cactorium/sweep-radar-proto-2.4GHz/digital/digital.kicad_pcb

## KiCad design digital/digital.kicad_pcb (2018-04-24)

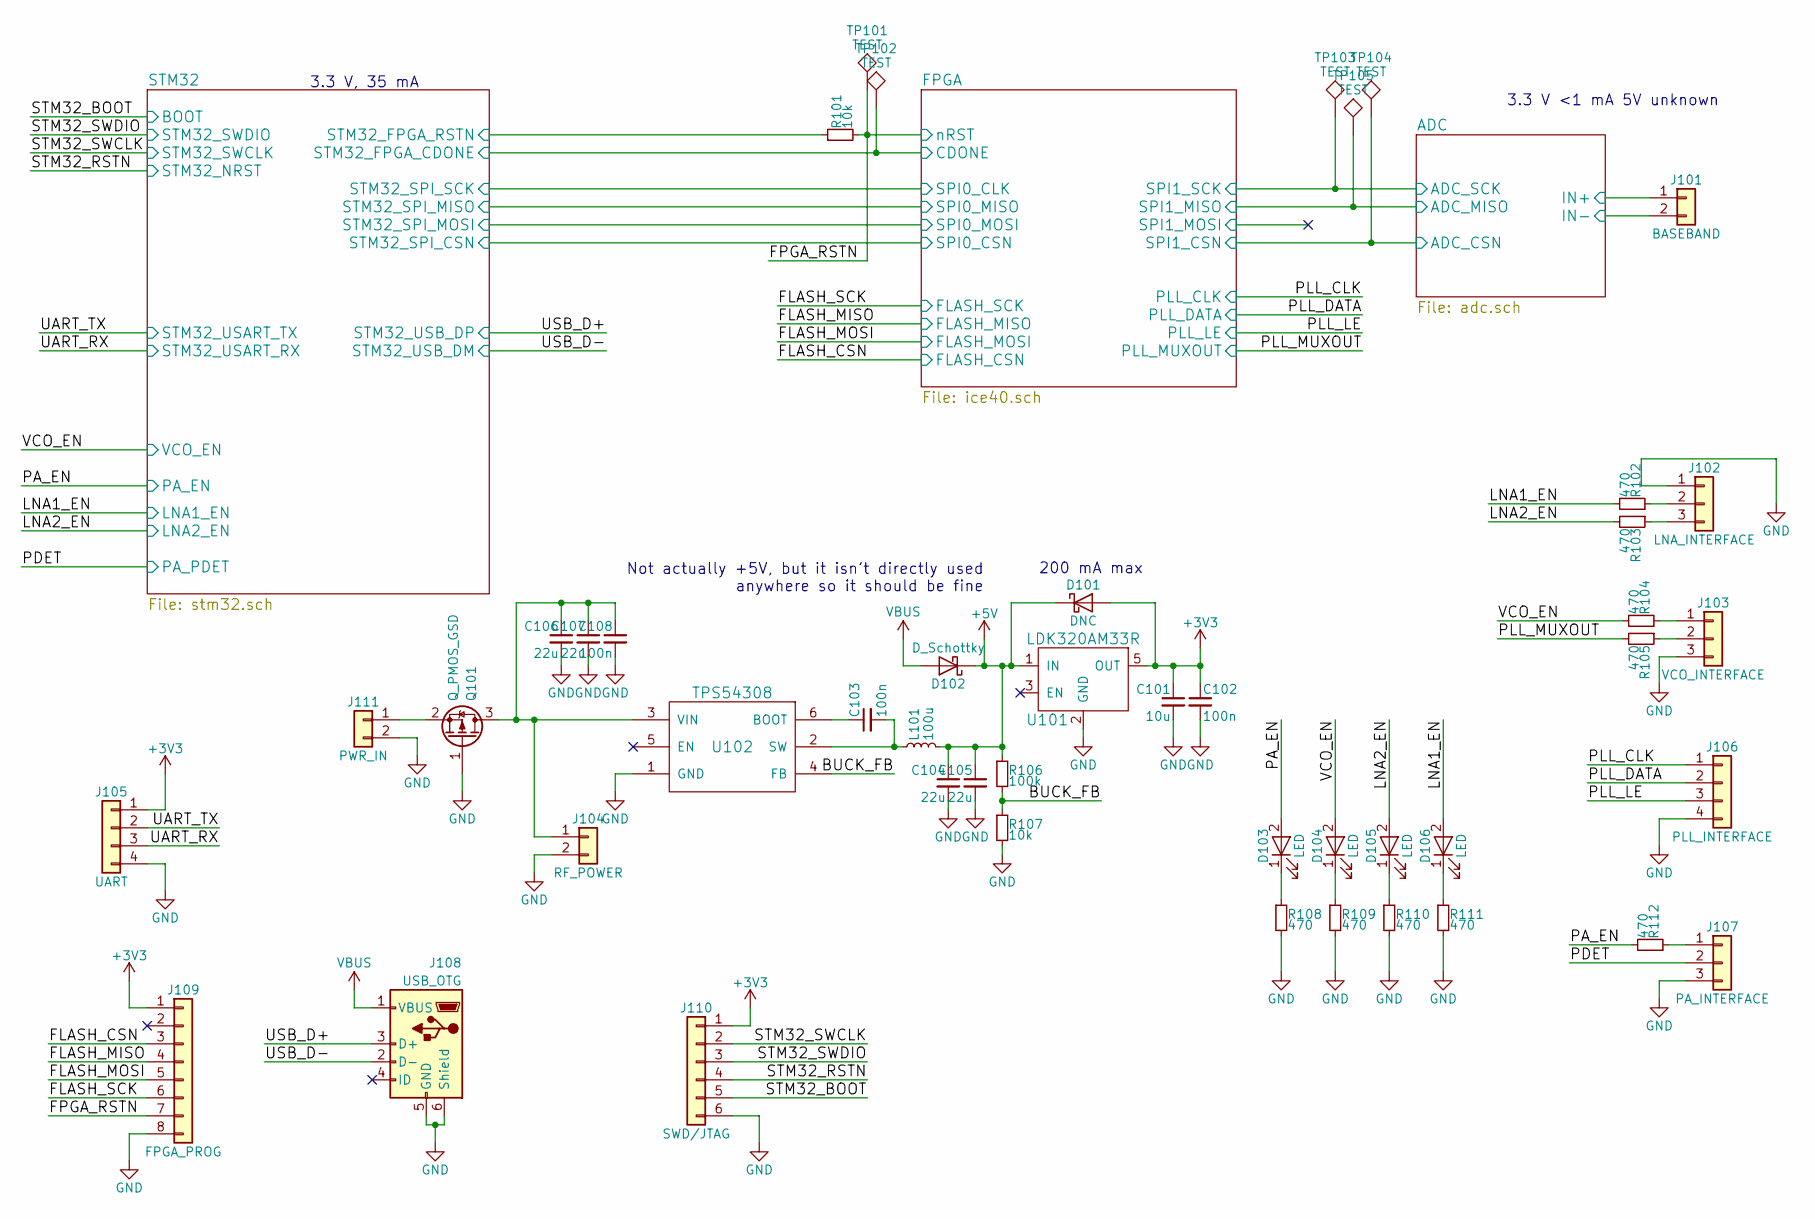
[picture p1: schematic digital.sch]

Parts:
C101: 10u; C_0805_HandSoldering
C102, C103, C108: 100n; C_0603_HandSoldering
C104, C105, C106, C107: 22u; C_1210_HandSoldering
D101: DNC; Panasonic_Diode-1006
D102: D_Schottky; Panasonic_Diode-1006
D103, D104, D105, D106: LED; D_0603
J101: BASEBAND; Pin_Header_Straight_1x02_Pitch2.54mm
J102: LNA_INTERFACE; Pin_Header_Straight_1x03_Pitch2.54mm
J103: VCO_INTERFACE; Pin_Header_Straight_1x03_Pitch2.54mm
J104: RF_POWER; Pin_Header_Straight_1x02_Pitch2.54mm
J105: UART; Pin_Header_Straight_2x02_Pitch2.54mm
J106: PLL_INTERFACE; Pin_Header_Straight_1x04_Pitch2.54mm
J107: PA_INTERFACE; Pin_Header_Straight_1x03_Pitch2.54mm
J108: USB_OTG; 10118194
J109: FPGA_PROG; Pin_Header_Straight_2x04_Pitch2.54mm
J110: SWD/JTAG; Pin_Header_Straight_2x03_Pitch2.54mm
J111: PWR_IN; Pin_Header_Straight_1x02_Pitch2.54mm
L101: 100u; Murata_DG6050C
Q101: Q_PMOS_GSD; SOT-23
R101, R107: 10k; R_0603_HandSoldering
R102, R103, R104, R105, R108, R109, R110, R111, R112: 470; R_0603_HandSoldering
R106: 100k; R_0402
TP101, TP102, TP103, TP104, TP105: TEST; Measurement_Point_Round-SMD-Pad_Small
U101: LDK320AM33R; ST_SOT23-5L
U102: TPS54308; TI-SOT-23-6

Connections:
+5V: C104.1, C105.1, D101.1 (K), D102.1 (K), L101.2, R106.1, U101.1 (IN); also elsewhere on the board
/ADC/ADC_CSN: TP104.1; also elsewhere on the board
/ADC/ADC_MISO: TP105.1; also elsewhere on the board
/ADC/ADC_SCK: TP103.1; also elsewhere on the board
/ADC/IN+: J101.1; also elsewhere on the board
/ADC/IN-: J101.2; also elsewhere on the board
/BUCK_FB: R106.2, R107.1, U102.4 (FB)
/FLASH_CSN: J109.3; also elsewhere on the board
/FLASH_MISO: J109.4; also elsewhere on the board
/FLASH_MOSI: J109.5; also elsewhere on the board
/FLASH_SCK: J109.6; also elsewhere on the board
/FPGA/CDONE: TP102.1; also elsewhere on the board
/FPGA_RSTN: J109.7, R101.2, TP101.1; also elsewhere on the board
/LNA1_EN: D106.2 (A), R102.2; also elsewhere on the board
/LNA2_EN: D105.2 (A), R103.2; also elsewhere on the board
/PA_EN: D103.2 (A), R112.2; also elsewhere on the board
/PDET: J107.2; also elsewhere on the board
/PLL_CLK: J106.1; also elsewhere on the board
/PLL_DATA: J106.2; also elsewhere on the board
/PLL_LE: J106.3; also elsewhere on the board
/PLL_MUXOUT: R105.2; also elsewhere on the board
/STM32/STM32_FPGA_RSTN: R101.1; also elsewhere on the board
/STM32_BOOT: J110.5; also elsewhere on the board
/STM32_RSTN: J110.4; also elsewhere on the board
/STM32_SWCLK: J110.2; also elsewhere on the board
/STM32_SWDIO: J110.3; also elsewhere on the board
/UART_RX: J105.3; also elsewhere on the board
/UART_TX: J105.2; also elsewhere on the board
/USB_D+: J108.3 (D+); also elsewhere on the board
/USB_D-: J108.2 (D-); also elsewhere on the board
/VCO_EN: D104.2 (A), R104.2; also elsewhere on the board
unnamed: C103.1, U102.6 (BOOT)
unnamed: C103.2, L101.1, U102.2 (SW)
unnamed: C106.1, C107.1, C108.1, J104.1, Q101.3 (D), U102.3 (VIN)
unnamed: D103.1 (K), R108.1
unnamed: D104.1 (K), R109.1
unnamed: D105.1 (K), R110.1
unnamed: D106.1 (K), R111.1
unnamed: J102.2, R102.1
unnamed: J102.3, R103.1
unnamed: J103.1, R104.1
unnamed: J103.2, R105.1
unnamed: J107.1, R112.1
unnamed: J111.1, Q101.2 (S)
VBUS: D102.2 (A), J108.1 (VBUS)

Notes on the sheet:
Not actually +5V, but it isn't directly used anywhere so it should be fine
200 mA max
3.3 V <1 mA 5V unknown
3.3 V, 35 mA

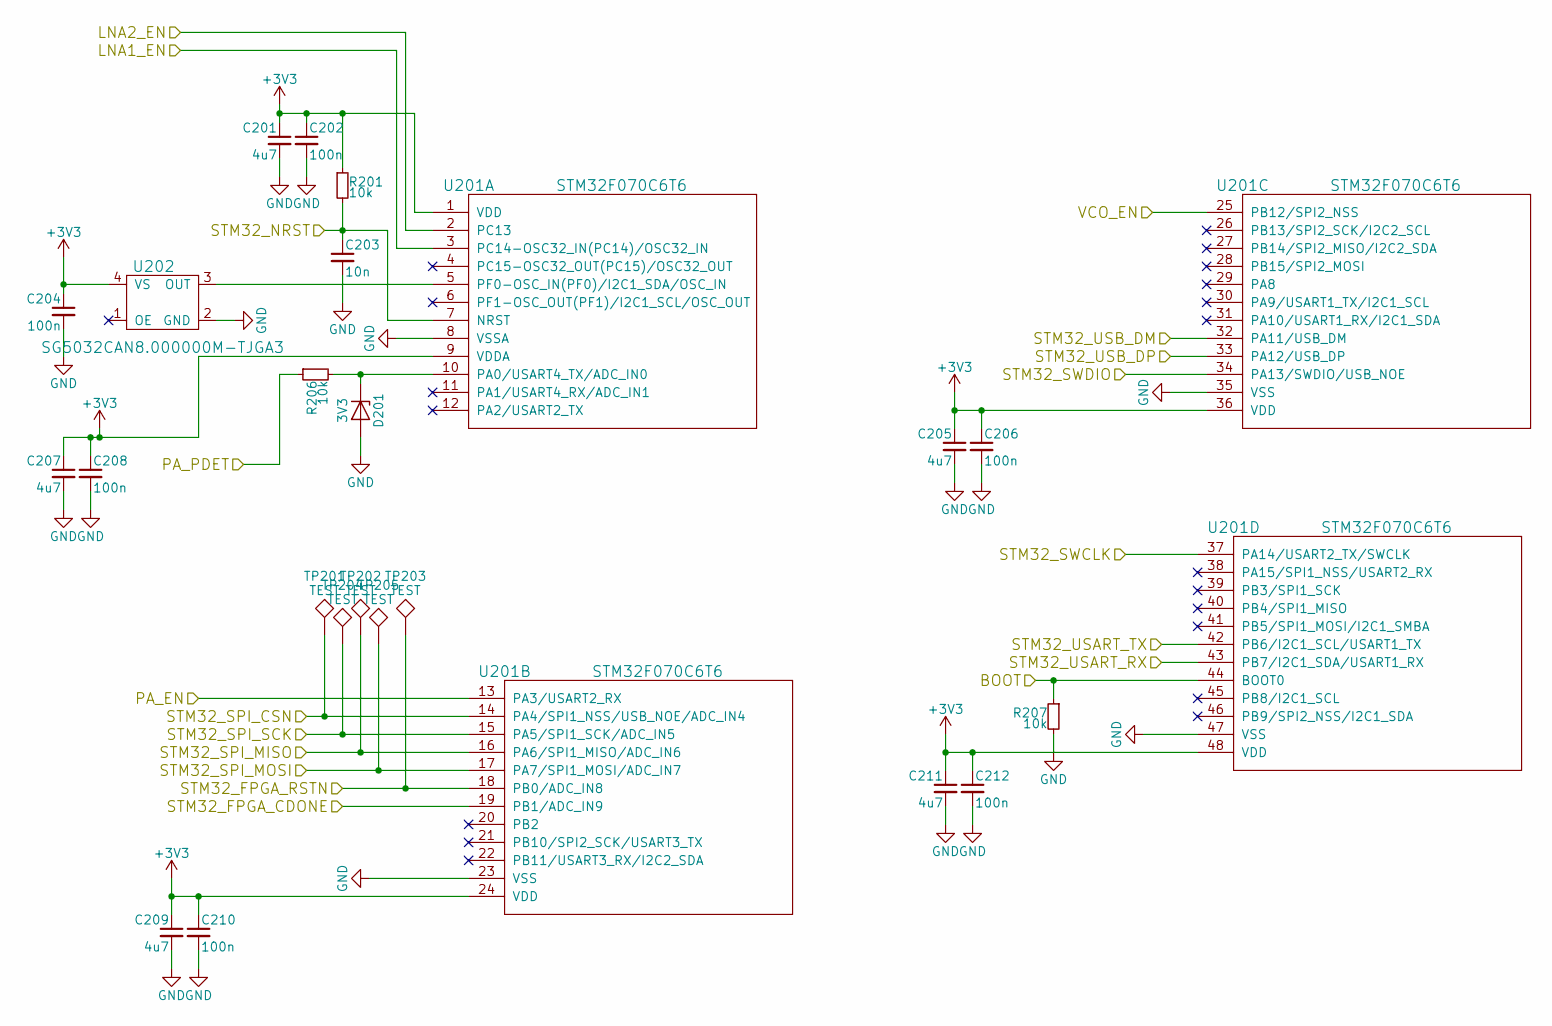
[picture p2: schematic stm32.sch]

Parts:
C201, C205, C207, C209, C211: 4u7; C_1206_HandSoldering
C202, C204, C206, C208, C210, C212: 100n; C_0603_HandSoldering
C203: 10n; C_0402
D201: 3V3; Diodes_SOD923
R201, R206, R207: 10k; R_0603_HandSoldering
TP201, TP202, TP203, TP204, TP205: TEST; Measurement_Point_Round-SMD-Pad_Small
U201: STM32F070C6T6; ST_LQFP48
U202: SG5032CAN8.000000M-TJGA3; Oscillator_SMD_SeikoEpson_SG8002LB-4pin_5.0x3.2mm_HandSolde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

Connections:
/FPGA/CDONE: U201.19 (PB1/ADC_IN9); also elsewhere on the board
/FPGA/SPI0_CLK: TP204.1, U201.15 (PA5/SPI1_SCK/ADC_IN5); also elsewhere on the board
/FPGA/SPI0_CSN: TP201.1, U201.14 (PA4/SPI1_NSS/USB_NOE/ADC_IN4); also elsewhere on the board
/FPGA/SPI0_MISO: TP202.1, U201.16 (PA6/SPI1_MISO/ADC_IN6); also elsewhere on the board
/FPGA/SPI0_MOSI: TP205.1, U201.17 (PA7/SPI1_MOSI/ADC_IN7); also elsewhere on the board
/LNA1_EN: U201.3 (PC14-OSC32_IN(PC14)/OSC32_IN); also elsewhere on the board
/LNA2_EN: U201.2 (PC13); also elsewhere on the board
/PA_EN: U201.13 (PA3/USART2_RX); also elsewhere on the board
/PDET: R206.1; also elsewhere on the board
/STM32/STM32_FPGA_RSTN: TP203.1, U201.18 (PB0/ADC_IN8); also elsewhere on the board
/STM32_BOOT: R207.1, U201.44 (BOOT0); also elsewhere on the board
/STM32_RSTN: C203.1, R201.2, U201.7 (NRST); also elsewhere on the board
/STM32_SWCLK: U201.37 (PA14/USART2_TX/SWCLK); also elsewhere on the board
/STM32_SWDIO: U201.34 (PA13/SWDIO/USB_NOE); also elsewhere on the board
/UART_RX: U201.43 (PB7/I2C1_SDA/USART1_RX); also elsewhere on the board
/UART_TX: U201.42 (PB6/I2C1_SCL/USART1_TX); also elsewhere on the board
/USB_D+: U201.33 (PA12/USB_DP); also elsewhere on the board
/USB_D-: U201.32 (PA11/USB_DM); also elsewhere on the board
/VCO_EN: U201.25 (PB12/SPI2_NSS); also elsewhere on the board
unnamed: D201.1 (K), R206.2, U201.10 (PA0/USART4_TX/ADC_IN0)
unnamed: U201.5 (PF0-OSC_IN(PF0)/I2C1_SDA/OSC_IN), U202.3 (OUT)

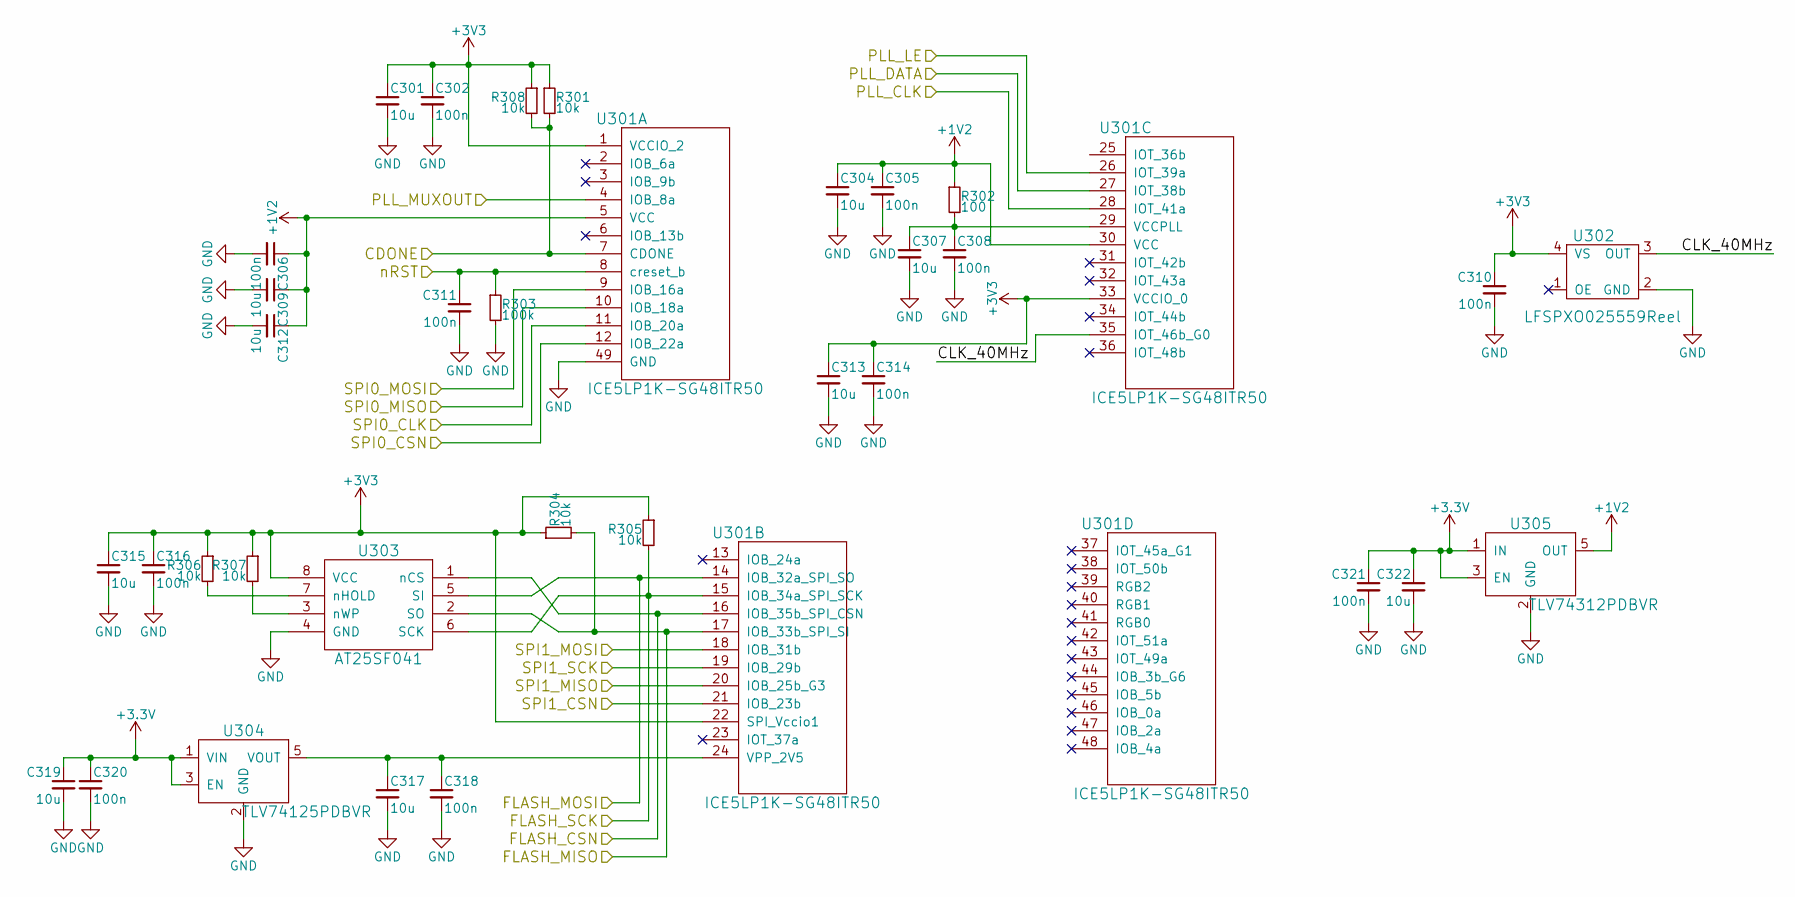
[picture p3: schematic ice40.sch]

Parts:
C301, C304, C307, C309, C312, C313, C315, C317, C319, C322: 10u; C_0805_HandSoldering
C302, C305, C306, C308, C310, C311, C314, C316, C318, C320, C321: 100n; C_0603_HandSoldering
R301, R304, R305, R306, R307, R308: 10k; R_0603_HandSoldering
R302: 100; R_0603_HandSoldering
R303: 100k; R_0402
U301: ICE5LP1K-SG48ITR50; Lattice_QFN48
U302: LFSPXO025559Reel; Crystal_SMD_3225-4pin_3.2x2.5mm_HandSoldering
U303: AT25SF041; SOIC-8_3.9x4.9mm_Pitch1.27mm
U304: TLV74125PDBVR; SOT-23-5_HandSoldering
U305: TLV74312PDBVR; SOT-23-5_HandSoldering

Connections:
+1V2: C304.1, C305.1, C306.1, C309.1, C312.1, R302.1, U301.5 (VCC), U301.30 (VCC), U305.5 (OUT)
/ADC/ADC_CSN: U301.21 (IOB_23b); also elsewhere on the board
/ADC/ADC_MISO: U301.20 (IOB_25b_G3); also elsewhere on the board
/ADC/ADC_SCK: U301.19 (IOB_29b); also elsewhere on the board
/FLASH_CSN: U301.16 (IOB_35b_SPI_CSN), U303.1 (nCS); also elsewhere on the board
/FLASH_MISO: R304.2, U301.17 (IOB_33b_SPI_SI), U303.2 (SO); also elsewhere on the board
/FLASH_MOSI: U301.14 (IOB_32a_SPI_SO), U303.5 (SI); also elsewhere on the board
/FLASH_SCK: R305.2, U301.15 (IOB_34a_SPI_SCK), U303.6 (SCK); also elsewhere on the board
/FPGA/CDONE: R301.2, R308.2, U301.7 (CDONE); also elsewhere on the board
/FPGA/CLK_40MHz: U301.35 (IOT_46b_G0), U302.3 (OUT)
/FPGA/SPI0_CLK: U301.11 (IOB_20a); also elsewhere on the board
/FPGA/SPI0_CSN: U301.12 (IOB_22a); also elsewhere on the board
/FPGA/SPI0_MISO: U301.10 (IOB_18a); also elsewhere on the board
/FPGA/SPI0_MOSI: U301.9 (IOB_16a); also elsewhere on the board
/FPGA_RSTN: C311.1, R303.1, U301.8 (creset_b); also elsewhere on the board
/PLL_CLK: U301.28 (IOT_41a); also elsewhere on the board
/PLL_DATA: U301.27 (IOT_38b); also elsewhere on the board
/PLL_LE: U301.26 (IOT_39a); also elsewhere on the board
/PLL_MUXOUT: U301.4 (IOB_8a); also elsewhere on the board
unnamed: C307.1, C308.1, R302.2, U301.29 (VCCPLL)
unnamed: C317.1, C318.1, U301.24 (VPP_2V5), U304.5 (VOUT)
unnamed: R306.2, U303.7 (nHOLD)
unnamed: R307.2, U303.3 (nWP)

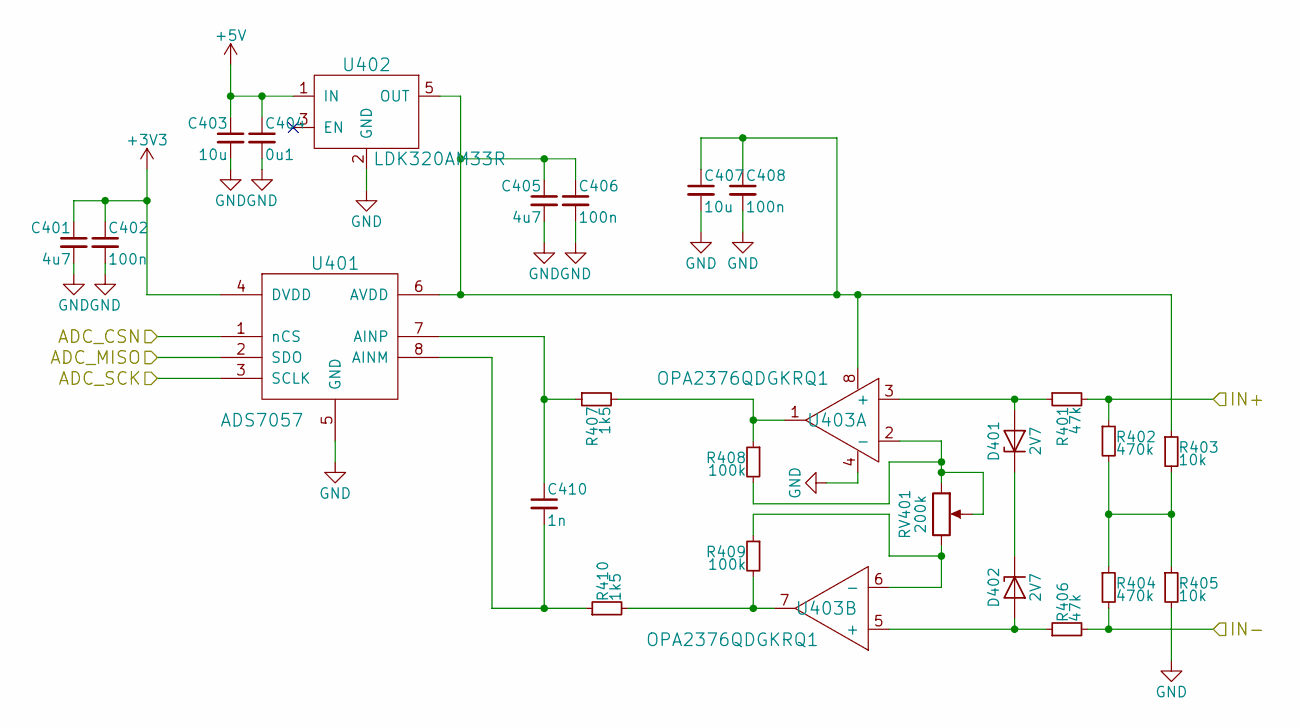
[picture p4: schematic adc.sch]

Parts:
C401, C405: 4u7; C_1206_HandSoldering
C402, C406, C408: 100n; C_0603_HandSoldering
C403, C407: 10u; C_0805_HandSoldering
C404: 0u1; C_0603_HandSoldering
C410: 1n; C_0603_HandSoldering
D401, D402: 2V7; D_SOD-323_HandSoldering
R401, R406: 47k; R_0603_HandSoldering
R402, R404: 470k; R_0402
R403, R405: 10k; R_0603_HandSoldering
R407, R410: 1k5; R_0402
R408, R409: 100k; R_0402
RV401: 200k; PT10LV10-204A2020
U401: ADS7057; TI_X2QFN8
U402: LDK320AM33R; ST_SOT23-5L
U403: OPA2376QDGKRQ1; TI_VSSOP8

Connections:
+5V: C403.1, C404.1, U402.1 (IN); also elsewhere on the board
/ADC/ADC_CSN: U401.1 (nCS); also elsewhere on the board
/ADC/ADC_MISO: U401.2 (SDO); also elsewhere on the board
/ADC/ADC_SCK: U401.3 (SCLK); also elsewhere on the board
/ADC/IN+: R401.2, R402.1; also elsewhere on the board
/ADC/IN-: R404.2, R406.2; also elsewhere on the board
unnamed: C405.1, C406.1, C407.1, C408.1, R403.1, U401.6 (AVDD), U402.5 (OUT), U403.8
unnamed: C410.1, R407.1, U401.7 (AINP)
unnamed: C410.2, R410.1, U401.8 (AINM)
unnamed: D401.1 (K), D402.1 (K)
unnamed: D401.2 (A), R401.1, U403.3 (+)
unnamed: D402.2 (A), R406.1, U403.5 (+)
unnamed: R402.2, R403.2, R404.1, R405.1
unnamed: R407.2, R408.1, U403.1
unnamed: R408.2, RV401.1, RV401.2, U403.2 (-)
unnamed: R409.1, RV401.3, U403.6 (-)
unnamed: R409.2, R410.2, U403.7

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
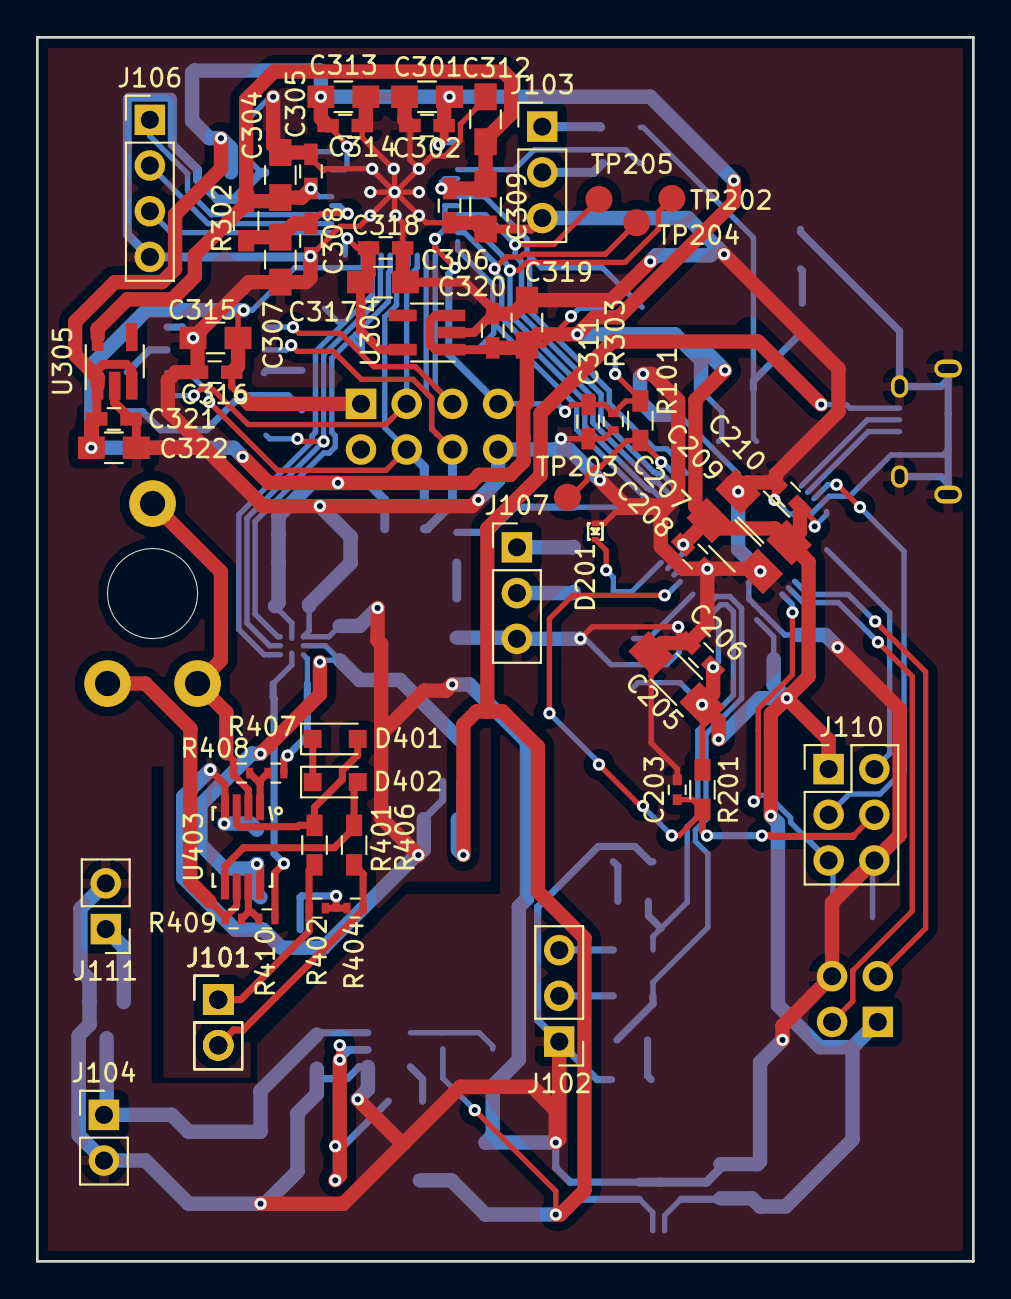
[picture p5: board digital.kicad_pcb from above]

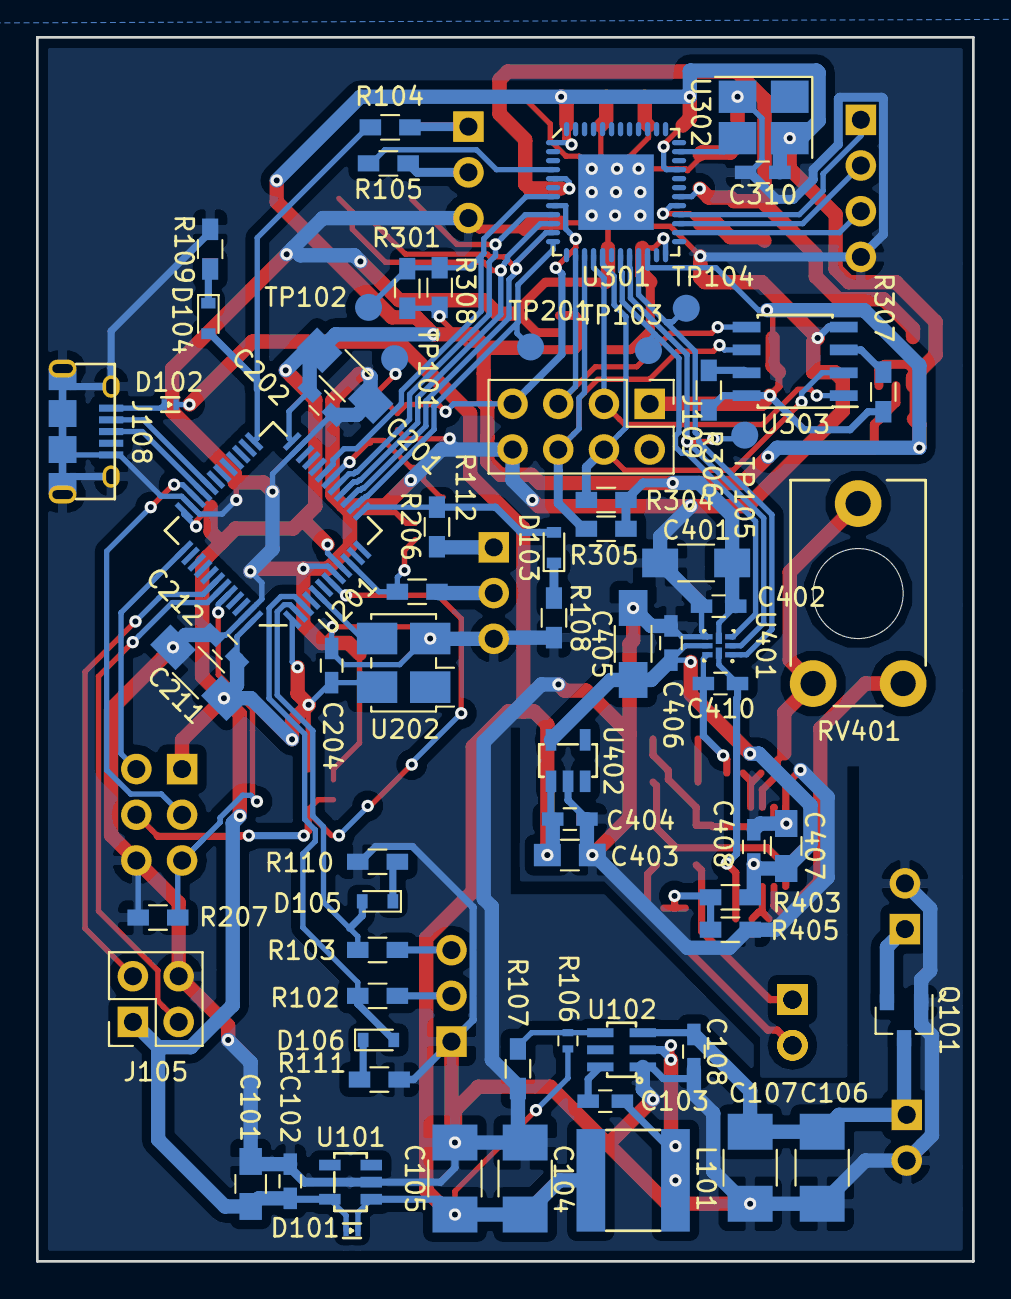
[picture p6: board digital.kicad_pcb from below]

Board: 2 copper layers, 52.0 x 68.0 mm, 129 parts (71 on the bottom side), 70 nets.

Other parts of the board:
J101#2: BASEBAND; Pin_Header_Straight_1x02_Pitch2.54mm

Their connections:
/ADC/IN+: J101#2.1; also elsewhere on the board
/ADC/IN-: J101#2.2; also elsewhere on the board
