cactorium/sweep-radar-proto-2.4GHz/rf/radar.kicad_pcb

## KiCad design rf/radar.kicad_pcb (2018-04-19)

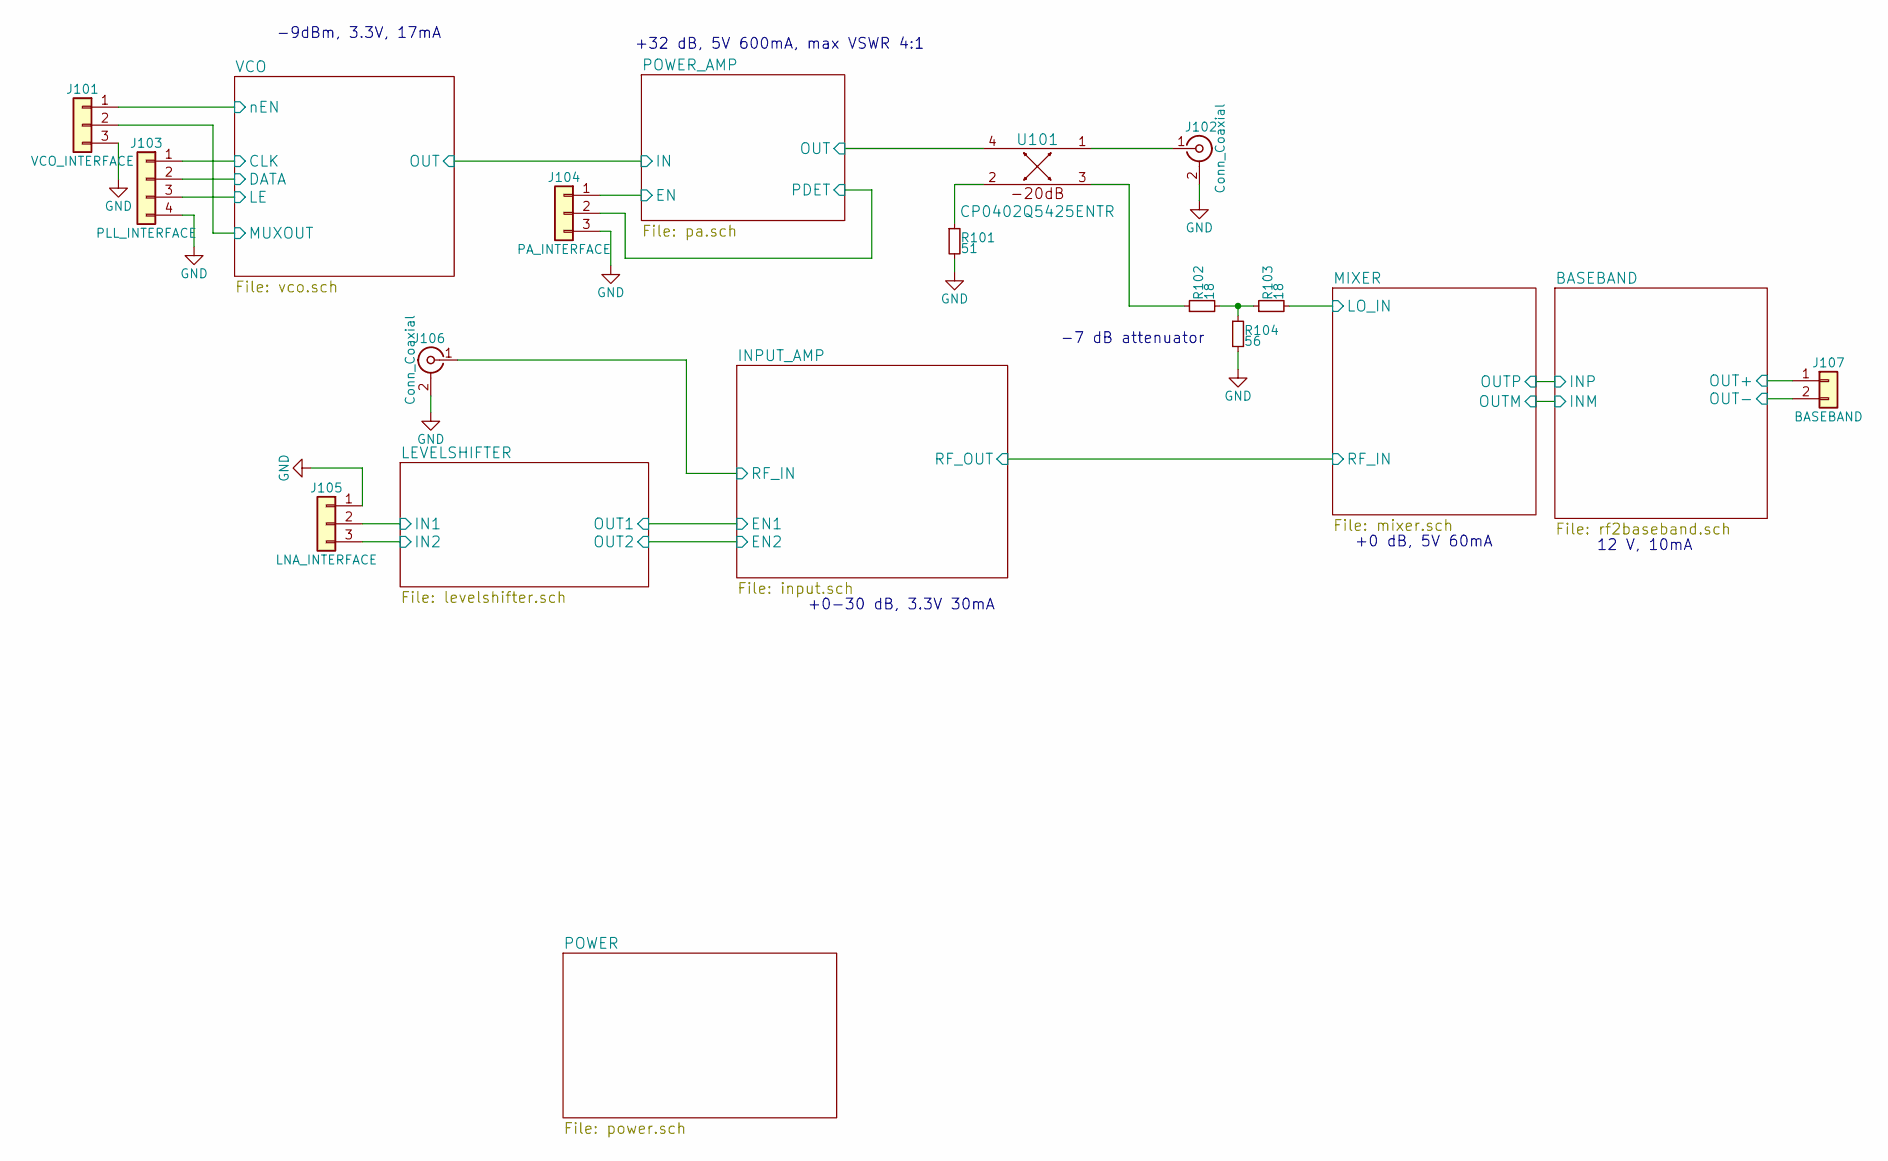
[picture p7: schematic radar.sch]

Parts:
J101: VCO_INTERFACE; Socket_Strip_Straight_1x03_Pitch2.54mm
J102, J106: Conn_Coaxial; 132322
J103: PLL_INTERFACE; Socket_Strip_Straight_1x04_Pitch2.54mm
J104: PA_INTERFACE; Socket_Strip_Straight_1x03_Pitch2.54mm
J105: LNA_INTERFACE; Socket_Strip_Straight_1x03_Pitch2.54mm
J107: BASEBAND; Pin_Header_Straight_1x02_Pitch2.54mm
R101: 51; R_0402
R102, R103: 18; R_0402
R104: 56; R_0402
U101: CP0402Q5425ENTR; CP0402

Connections:
/BASEBAND/OUT+: J107.1; also elsewhere on the board
/BASEBAND/OUT-: J107.2; also elsewhere on the board
/INPUT_AMP/RF_IN: J106.1 (In); also elsewhere on the board
/LEVELSHIFTER/IN1: J105.2; also elsewhere on the board
/LEVELSHIFTER/IN2: J105.3; also elsewhere on the board
/MIXER/LO_IN: R103.2; also elsewhere on the board
/POWER_AMP/EN: J104.1; also elsewhere on the board
/POWER_AMP/OUT: U101.4; also elsewhere on the board
/POWER_AMP/PDET: J104.2; also elsewhere on the board
/VCO/CLK: J103.1; also elsewhere on the board
/VCO/DATA: J103.2; also elsewhere on the board
/VCO/LE: J103.3; also elsewhere on the board
/VCO/MUXOUT: J101.2; also elsewhere on the board
/VCO/nEN: J101.1; also elsewhere on the board
GND: J101.3, J102.2 (Ext), J103.4, J104.3, J105.1, J106.2 (Ext), R101.2, R104.2; also elsewhere on the board
unnamed: J102.1 (In), U101.1
unnamed: R101.1, U101.2
unnamed: R102.1, U101.3
unnamed: R102.2, R103.1, R104.1

Notes on the sheet:
-9dBm, 3.3V, 17mA
+32 dB, 5V 600mA, max VSWR 4:1
+0 dB, 5V 60mA
+0-30 dB, 3.3V 30mA
12 V, 10mA
-7 dB attenuator

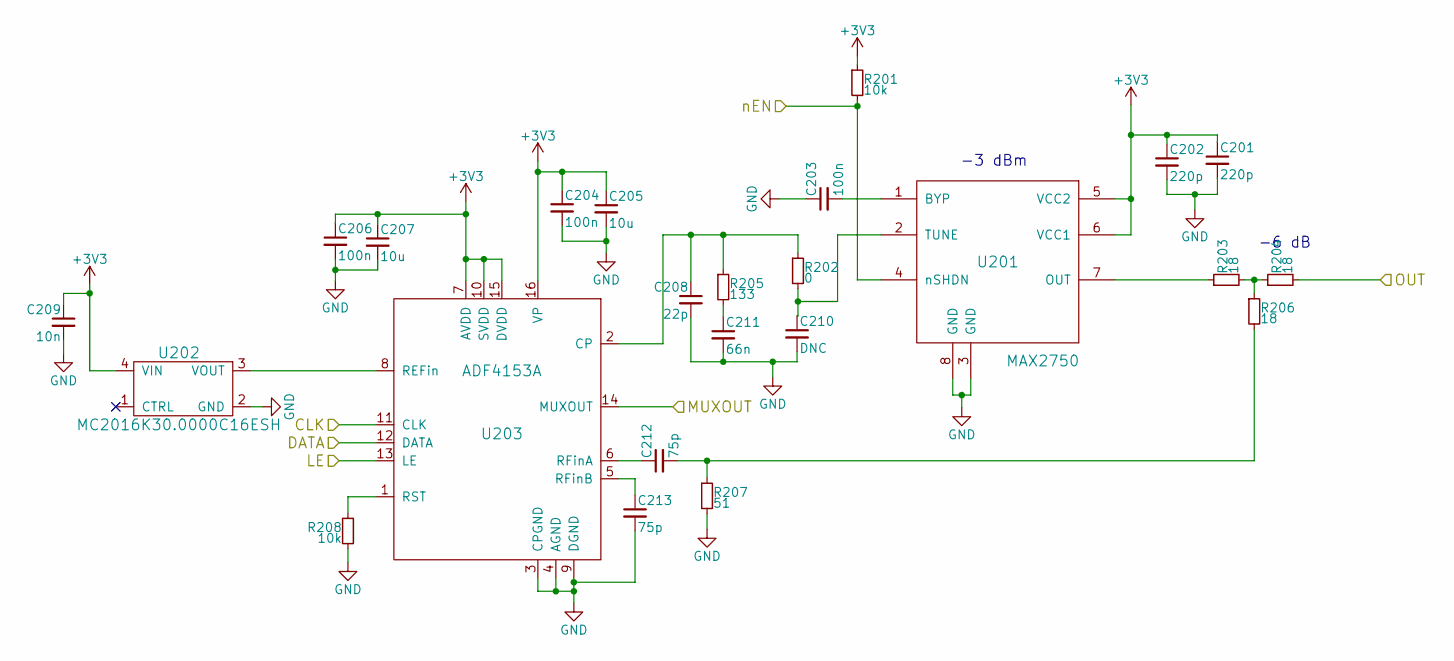
[picture p8: schematic vco.sch]

Parts:
C201, C202: 220p; C_0402
C203, C204, C206: 100n; C_0603_HandSoldering
C205, C207: 10u; C_0805_HandSoldering
C208: 22p; C_0603_HandSoldering
C209: 10n; C_0402
C210: DNC; C_0603_HandSoldering
C211: 66n; C_0805_HandSoldering
C212, C213: 75p; C_0402
R201, R208: 10k; R_0603_HandSoldering
R202: 0; R_0603_HandSoldering
R203, R204: 18; R_0402
R205: 133; R_0805_HandSoldering
R206: 18; C_0402
R207: 51; R_0402
U201: MAX2750; U8+1
U202: MC2016K30.0000C16ESH
U203: ADF4153A; TSSOP-16

Connections:
+3V3: C201.1, C202.1, C204.1, C205.1, C206.1, C207.1, C209.1, R201.1, U201.5 (VCC2), U201.6 (VCC1), U202.4 (VIN), U203.7 (AVDD), U203.10 (SVDD), U203.15 (DVDD), U203.16 (VP); also elsewhere on the board
/POWER_AMP/IN: R204.2; also elsewhere on the board
/VCO/CLK: U203.11 (CLK); also elsewhere on the board
/VCO/DATA: U203.12 (DATA); also elsewhere on the board
/VCO/LE: U203.13 (LE); also elsewhere on the board
/VCO/MUXOUT: U203.14 (MUXOUT); also elsewhere on the board
/VCO/nEN: R201.2, U201.4 (nSHDN); also elsewhere on the board
GND: C201.2, C202.2, C203.1, C204.2, C205.2, C206.2, C207.2, C208.2, C209.2, C210.2, C211.2, C213.2, R207.2, R208.2, U201.3 (GND), U201.8 (GND), U202.2 (GND), U203.3 (CPGND), U203.4 (AGND), U203.9 (DGND); also elsewhere on the board
unnamed: C203.2, U201.1 (BYP)
unnamed: C208.1, R202.1, R205.1, U203.2 (CP)
unnamed: C210.1, R202.2, U201.2 (TUNE)
unnamed: C211.1, R205.2
unnamed: C212.1, U203.6 (RFinA)
unnamed: C212.2, R206.2, R207.1
unnamed: C213.1, U203.5 (RFinB)
unnamed: R203.1, U201.7 (OUT)
unnamed: R203.2, R204.1, R206.1
unnamed: R208.1, U203.1 (RST)
unnamed: U202.3 (VOUT), U203.8 (REFin)

Notes on the sheet:
-6 dB
-3 dBm

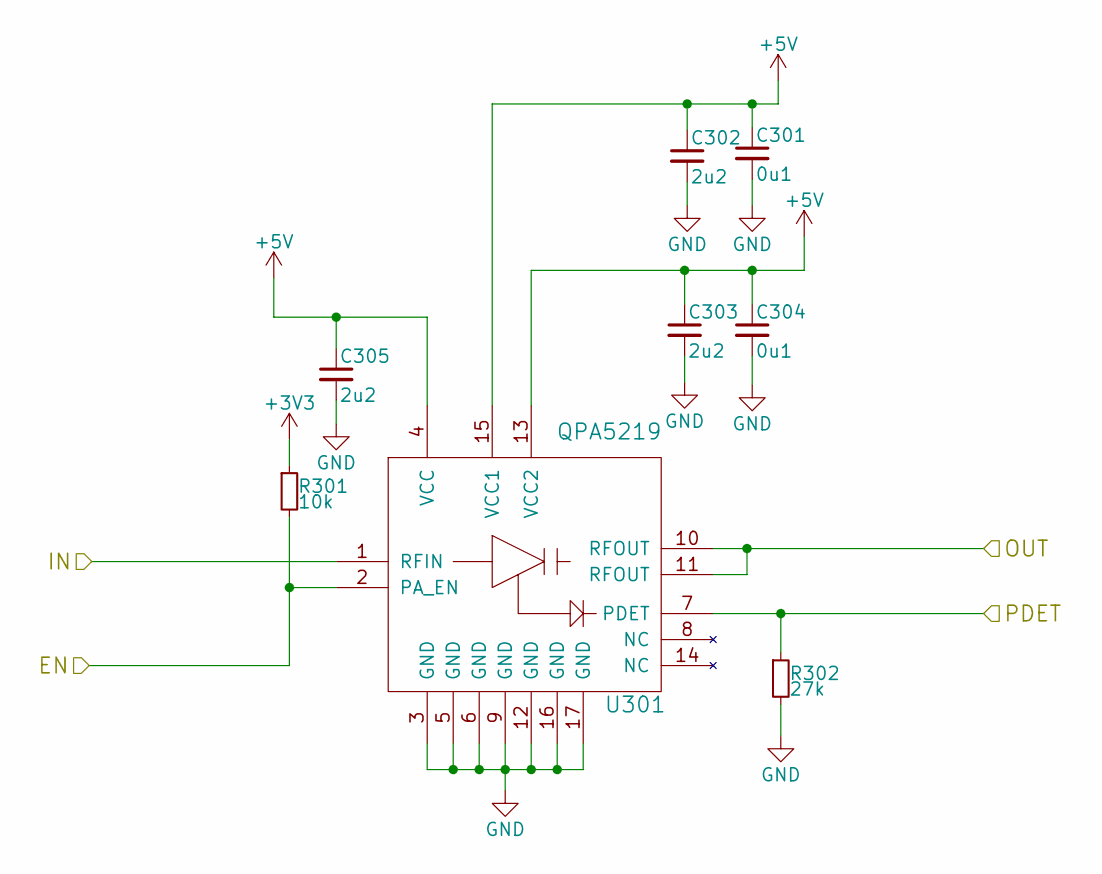
[picture p9: schematic pa.sch]

Parts:
C301, C304: 0u1; C_0603_HandSoldering
C302, C303, C305: 2u2; C_0805_HandSoldering
R301: 10k; R_0603_HandSoldering
R302: 27k; R_0603_HandSoldering
U301: QPA5219

Connections:
+3V3: R301.1; also elsewhere on the board
+5V: C301.1, C302.1, C303.1, C304.1, C305.1, U301.4 (VCC), U301.13 (VCC2), U301.15 (VCC1); also elsewhere on the board
/POWER_AMP/EN: R301.2, U301.2 (PA_EN); also elsewhere on the board
/POWER_AMP/IN: U301.1 (RFIN); also elsewhere on the board
/POWER_AMP/OUT: U301.10 (RFOUT), U301.11 (RFOUT); also elsewhere on the board
/POWER_AMP/PDET: R302.1, U301.7 (PDET); also elsewhere on the board
GND: C301.2, C302.2, C303.2, C304.2, C305.2, R302.2, U301.3 (GND), U301.5 (GND), U301.6 (GND), U301.9 (GND), U301.12 (GND), U301.16 (GND), U301.17 (GND); also elsewhere on the board

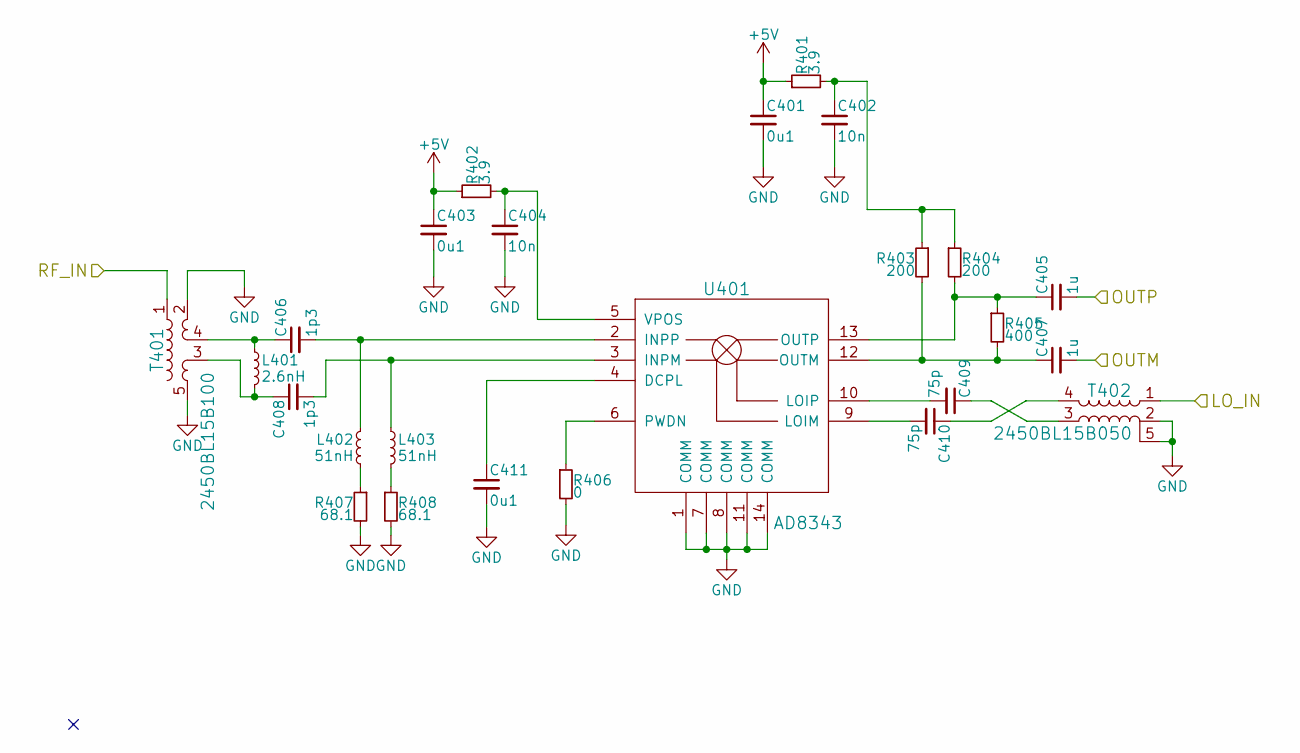
[picture p10: schematic mixer.sch]

Parts:
C401, C403, C411: 0u1; C_0603_HandSoldering
C402, C404: 10n; C_0402
C405, C407: 1u; C_0603_HandSoldering
C406, C408: 1p3; C_0201
C409, C410: 75p; C_0402
L401: 2.6nH; C_0201
L402, L403: 51nH; C_0402
R401, R402: 3.9; R_0603_HandSoldering
R403, R404: 200; R_1206_HandSoldering
R405: 400; R_1206_HandSoldering
R406: 0; R_0603_HandSoldering
R407, R408: 68.1; R_1206_HandSoldering
T401: 2450BL15B100
T402: 2450BL15B050; 2450BL15B100
U401: AD8343; TSSOP-14_4.4x5mm_Pitch0.65mm

Connections:
+5V: C401.1, C403.1, R401.1, R402.1; also elsewhere on the board
/BASEBAND/INM: C407.2; also elsewhere on the board
/BASEBAND/INP: C405.2; also elsewhere on the board
/MIXER/LO_IN: T402.1; also elsewhere on the board
/MIXER/RF_IN: T401.1; also elsewhere on the board
GND: C401.2, C402.2, C403.2, C404.2, C411.2, R406.2, R407.2, R408.2, T401.2, T401.5, T402.2, T402.5, U401.1 (COMM), U401.7 (COMM), U401.8 (COMM), U401.11 (COMM), U401.14 (COMM); also elsewhere on the board
unnamed: C402.1, R401.2, R403.1, R404.1
unnamed: C404.1, R402.2, U401.5 (VPOS)
unnamed: C405.1, R404.2, R405.1, U401.13 (OUTP)
unnamed: C406.1, L401.1, T401.4
unnamed: C406.2, L402.1, U401.2 (INPP)
unnamed: C407.1, R403.2, R405.2, U401.12 (OUTM)
unnamed: C408.1, L401.2, T401.3
unnamed: C408.2, L403.1, U401.3 (INPM)
unnamed: C409.1, T402.3
unnamed: C409.2, U401.10 (LOIP)
unnamed: C410.1, T402.4
unnamed: C410.2, U401.9 (LOIM)
unnamed: C411.1, U401.4 (DCPL)
unnamed: L402.2, R407.1
unnamed: L403.2, R408.1
unnamed: R406.1, U401.6 (PWDN)
