cactorium/sweep-radar-proto-2.4GHz/rf/radar.kicad_pcb

## KiCad design rf/radar.kicad_pcb (continued)

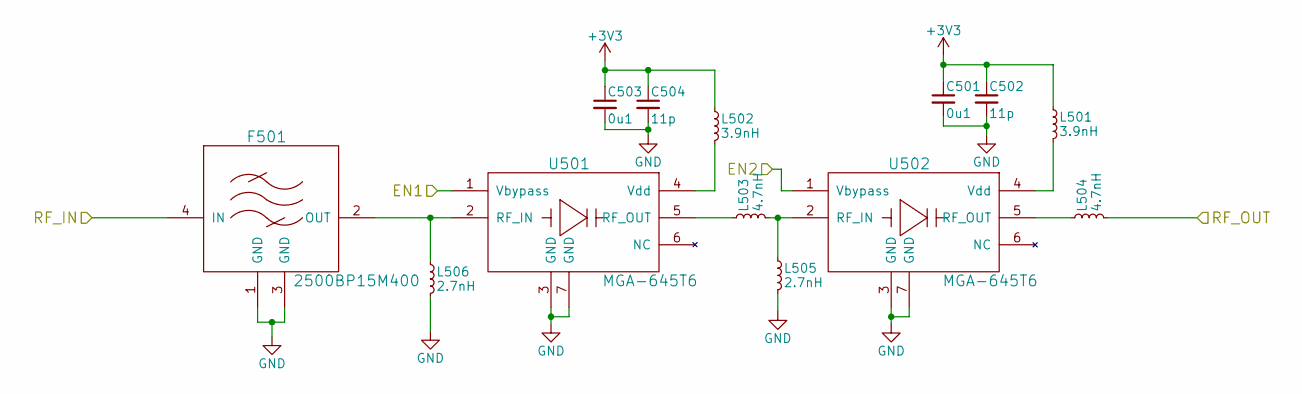
[picture p11: schematic input.sch]

Parts:
C501, C503: 0u1; C_0603_HandSoldering
C502, C504: 11p; C_0402
F501: 2500BP15M400
L501, L502: 3.9nH; C_0402
L503, L504: 4.7nH; C_0402
L505, L506: 2.7nH; C_0402
U501, U502: MGA-645T6

Connections:
+3V3: C501.1, C502.1, C503.1, C504.1, L501.1, L502.1; also elsewhere on the board
/INPUT_AMP/EN1: U501.1 (Vbypass); also elsewhere on the board
/INPUT_AMP/EN2: U502.1 (Vbypass); also elsewhere on the board
/INPUT_AMP/RF_IN: F501.4 (IN); also elsewhere on the board
/MIXER/RF_IN: L504.2; also elsewhere on the board
GND: C501.2, C502.2, C503.2, C504.2, F501.1 (GND), F501.3 (GND), L505.2, L506.2, U501.3 (GND), U501.7 (GND), U502.3 (GND), U502.7 (GND); also elsewhere on the board
unnamed: F501.2 (OUT), L506.1, U501.2 (RF_IN)
unnamed: L501.2, U502.4 (Vdd)
unnamed: L502.2, U501.4 (Vdd)
unnamed: L503.1, U501.5 (RF_OUT)
unnamed: L503.2, L505.1, U502.2 (RF_IN)
unnamed: L504.1, U502.5 (RF_OUT)

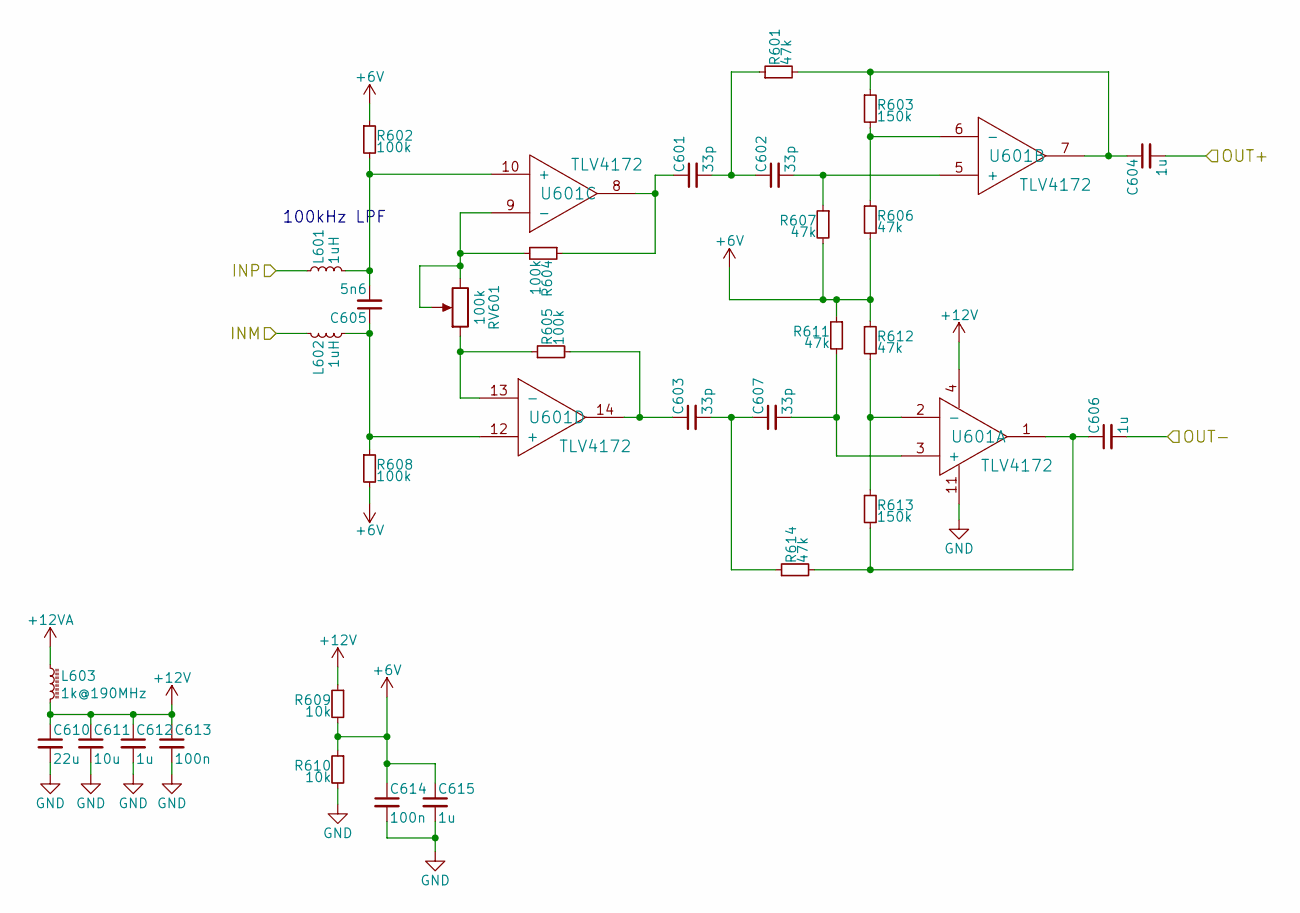
[picture p12: schematic rf2baseband.sch]

Parts:
C601, C602, C603, C607: 33p; C_0603_HandSoldering
C604, C606, C612, C615: 1u; C_0603_HandSoldering
C605: 5n6; C_0603_HandSoldering
C610: 22u; C_1210_HandSoldering
C611: 10u; C_0805_HandSoldering
C613, C614: 100n; C_0603_HandSoldering
L601, L602: 1uH; C_0402
L603: 1k@190MHz; C_0402
R601, R606, R607, R611, R612, R614: 47k; R_0603_HandSoldering
R602, R604, R605, R608: 100k; R_0402
R603, R613: 150k; R_0402
R609, R610: 10k; R_0402
RV601: 100k; RK09D113
U601: TLV4172; TSSOP-14_4.4x5mm_Pitch0.65mm

Connections:
+6V: C614.1, C615.1, R602.1, R606.2, R607.2, R608.2, R609.2, R610.1, R611.1, R612.1
+12V: C610.1, C611.1, C612.1, C613.1, L603.2, R609.1, U601.4
+12VA: L603.1; also elsewhere on the board
/BASEBAND/INM: L602.1; also elsewhere on the board
/BASEBAND/INP: L601.1; also elsewhere on the board
/BASEBAND/OUT+: C604.2; also elsewhere on the board
/BASEBAND/OUT-: C606.2; also elsewhere on the board
GND: C610.2, C611.2, C612.2, C613.2, C614.2, C615.2, R610.2, U601.11; also elsewhere on the board
unnamed: C601.1, R604.1, U601.8
unnamed: C601.2, C602.1, R601.1
unnamed: C602.2, R607.1, U601.5 (+)
unnamed: C603.1, R605.2, U601.14
unnamed: C603.2, C607.1, R614.1
unnamed: C604.1, R601.2, R603.1, U601.7
unnamed: C605.1, L602.2, R608.1, U601.12 (+)
unnamed: C605.2, L601.2, R602.2, U601.10 (+)
unnamed: C606.1, R613.2, R614.2, U601.1
unnamed: C607.2, R611.2, U601.3 (+)
unnamed: R603.2, R606.1, U601.6 (-)
unnamed: R604.2, RV601.2, RV601.3, U601.9 (-)
unnamed: R605.1, RV601.1, U601.13 (-)
unnamed: R612.2, R613.1, U601.2 (-)

Notes on the sheet:
100kHz LPF

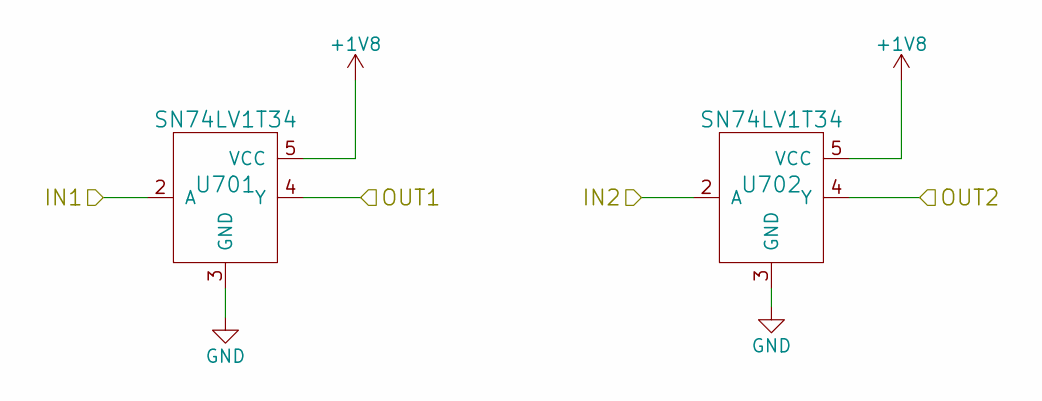
[picture p13: schematic levelshifter.sch]

Parts:
U701, U702: SN74LV1T34; SOT-23-5_HandSoldering

Connections:
+1V8: U701.5 (VCC), U702.5 (VCC); also elsewhere on the board
/INPUT_AMP/EN1: U701.4 (Y); also elsewhere on the board
/INPUT_AMP/EN2: U702.4 (Y); also elsewhere on the board
/LEVELSHIFTER/IN1: U701.2 (A); also elsewhere on the board
/LEVELSHIFTER/IN2: U702.2 (A); also elsewhere on the board
GND: U701.3 (GND), U702.3 (GND); also elsewhere on the board

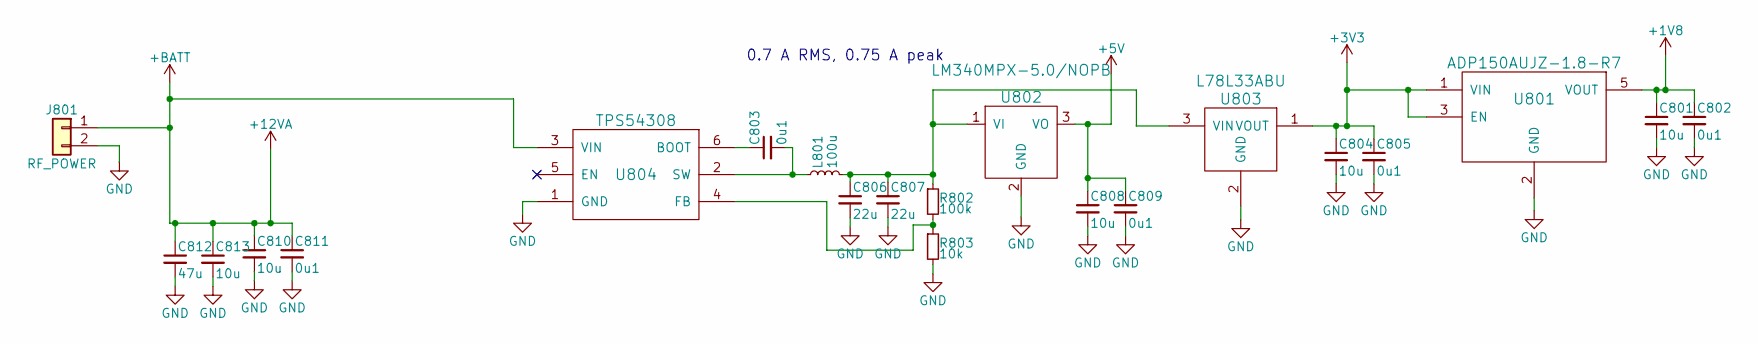
[picture p14: schematic power.sch]

Parts:
C801, C804, C808, C810, C813: 10u; C_0805_HandSoldering
C802, C803, C805, C809, C811: 0u1; C_0603_HandSoldering
C806, C807: 22u; C_1210_HandSoldering
C812: 47u; CP_Radial_D5.0mm_P2.00mm
J801: RF_POWER; Socket_Strip_Straight_1x02_Pitch2.54mm
L801: 100u; Murata_DG6050C
R802: 100k; R_0402
R803: 10k; R_0603_HandSoldering
U801: ADP150AUJZ-1.8-R7; TSOT-23
U802: LM340MPX-5.0/NOPB; SOT-223-3_TabPin2
U803: L78L33ABU; SOT-89-3_Handsoldering
U804: TPS54308; TI-SOT-23-6

Connections:
+1V8: C801.1, C802.1, U801.5 (VOUT); also elsewhere on the board
+3V3: C804.1, C805.1, U801.1 (VIN), U801.3 (EN), U803.1 (VOUT); also elsewhere on the board
+5V: C808.1, C809.1, U802.3 (VO); also elsewhere on the board
+12VA: C810.1, C811.1, C812.1, C813.1, J801.1, U804.3 (VIN); also elsewhere on the board
GND: C801.2, C802.2, C804.2, C805.2, C806.2, C807.2, C808.2, C809.2, C810.2, C811.2, C812.2, C813.2, J801.2, R803.2, U801.2 (GND), U802.2 (GND), U803.2 (GND), U804.1 (GND); also elsewhere on the board
unnamed: C803.1, U804.6 (BOOT)
unnamed: C803.2, L801.1, U804.2 (SW)
unnamed: C806.1, C807.1, L801.2, R802.1, U802.1 (VI), U803.3 (VIN)
unnamed: R802.2, R803.1, U804.4 (FB)

Notes on the sheet:
0.7 A RMS, 0.75 A peak

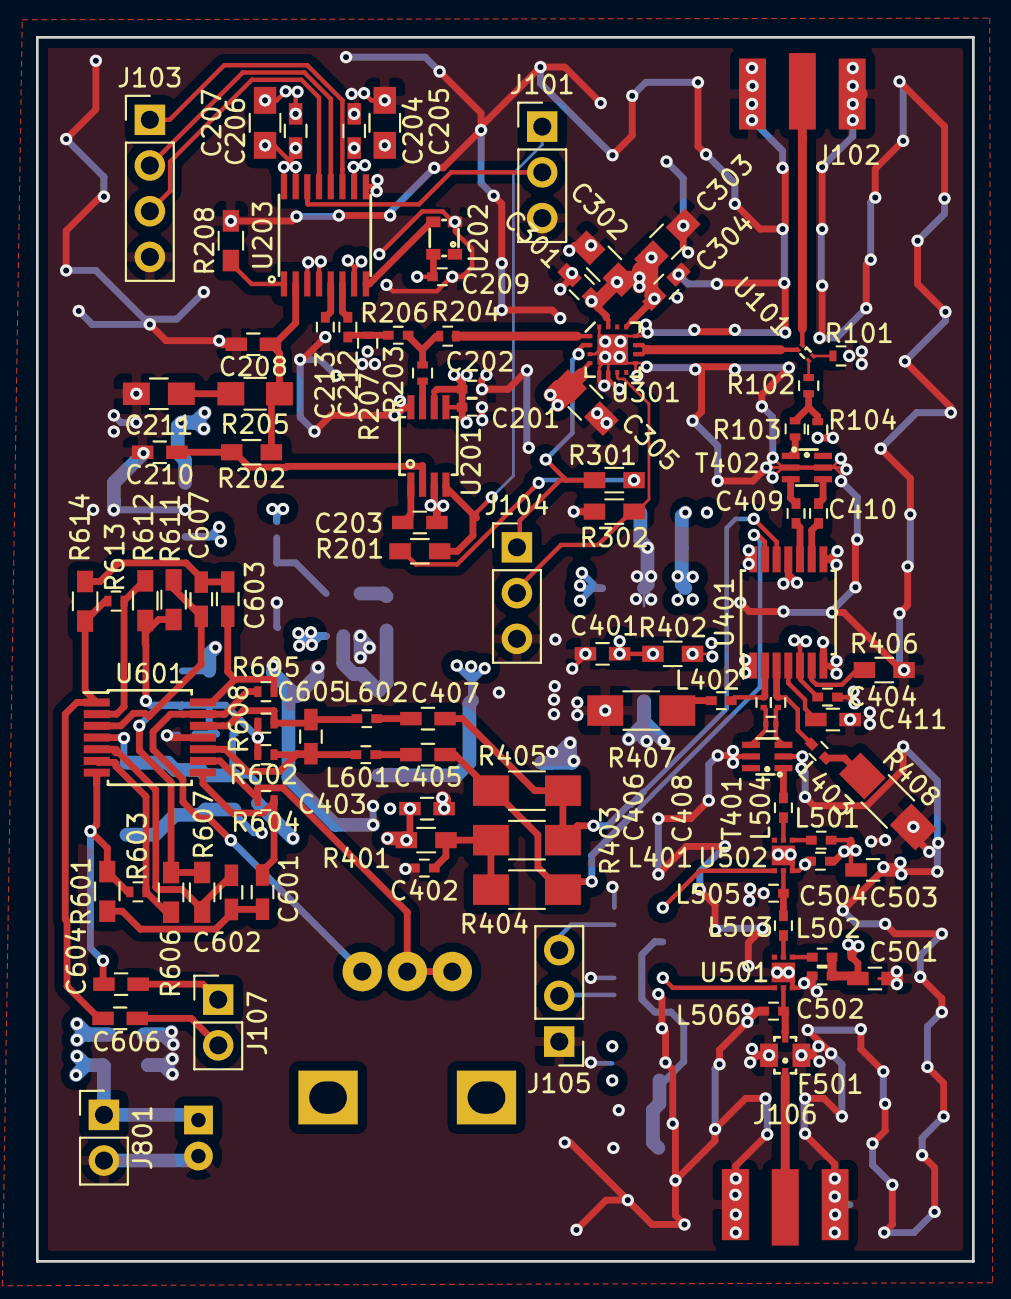
[picture p15: board radar.kicad_pcb from above]

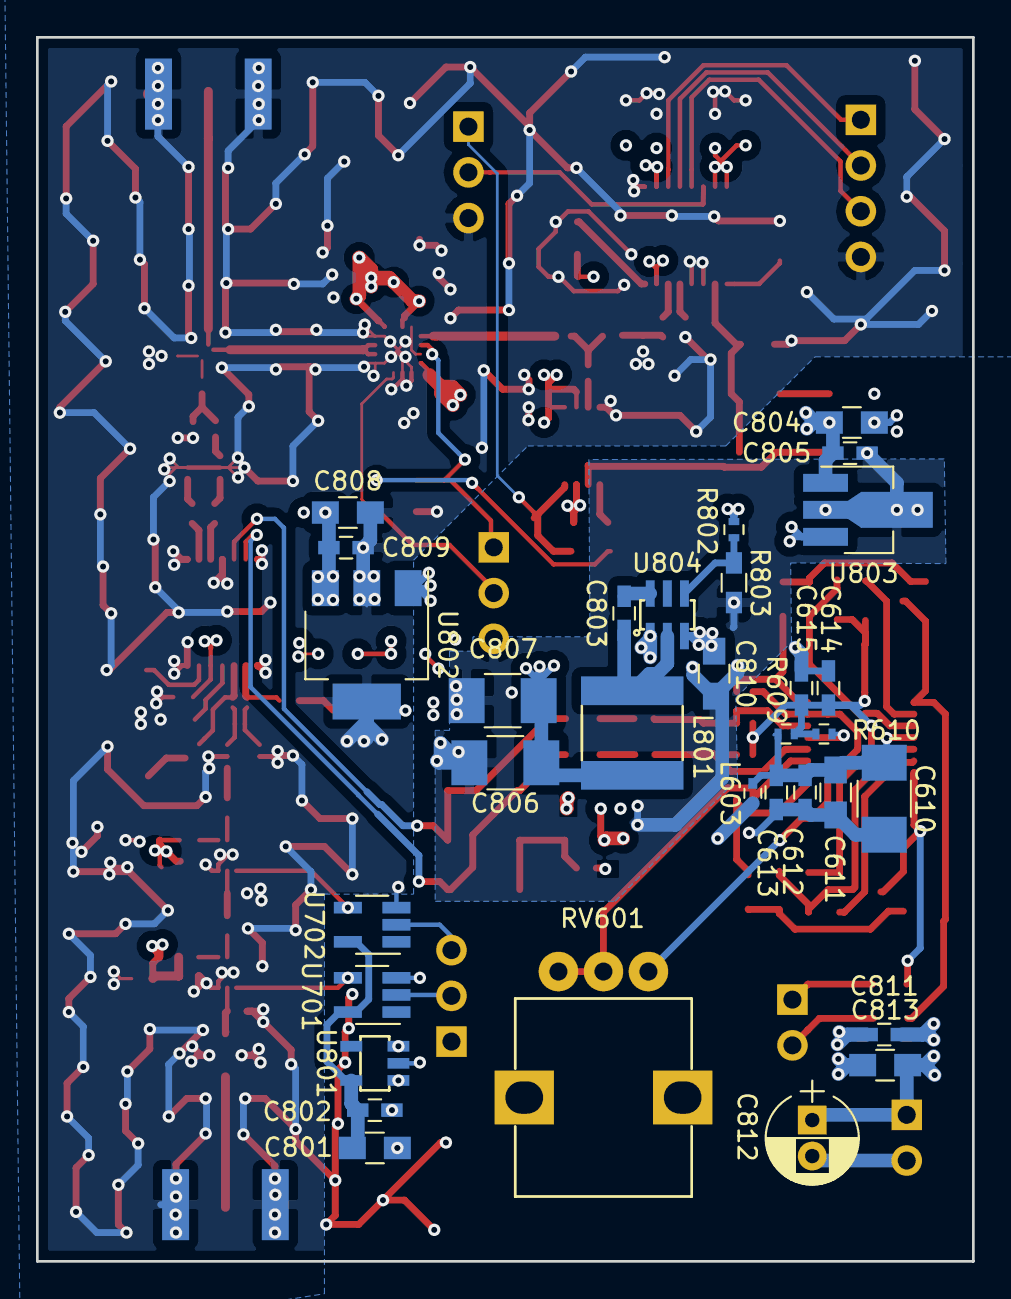
[picture p16: board radar.kicad_pcb from below]

Board: 4 copper layers, 52.0 x 68.0 mm, 137 parts (32 on the bottom side), 82 nets.
