cactorium/sweep-radar-proto-2.4GHz/(commit log)

2017-10-14 All of it planned out; time to move to layout
    [input.sch, mixer.sch, pa.sch, radar.kicad_pcb, radar.sch, rf2baseband.sch, splitter.sch, vco.sch]
2018-01-06 Schematic finished
    [input.sch, levelshifter.sch, mixer.sch, pa.sch, radar.sch, rf2baseband.sch, splitter.sch, vco.sch]
2018-02-10 Assign a lot of footprints, fix l78l33abu part (input and output were reversed)
    [input.sch, levelshifter.sch, mixer.sch, pa.sch, radar.sch, rf2baseband.sch, splitter.sch, vco.sch]
2018-03-31 Finished circuit layout (for the RF board)
    [input.sch, levelshifter.sch, mixer.sch, pa.sch, power.sch, radar.sch, rf2baseband.sch, splitter.sch]
2018-04-04 Switch signal conditioning to fully differential
    [radar.sch, rf2baseband.sch]
2018-04-04 Move everything into RF folder
    [input.sch, levelshifter.sch, mixer.sch, pa.sch, power.sch, radar.kicad_pcb, radar.sch, rf2baseband.sch]
2018-04-08 Finish assigning component footprints
    [input.sch, levelshifter.sch, mixer.sch, pa.sch, power.sch, radar.sch, rf2baseband.sch, vco.sch]
2018-04-12 Finish first revision layout
    [input.sch, levelshifter.sch, mixer.sch, pa.sch, power.sch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]
2018-04-13 Clean up PCB slightly
    [radar-B.Cu.gbr, radar-B.Mask.gbr, radar-B.SilkS.gbr, radar-Edge.Cuts.gbr, radar-F.Cu.gbr, radar-F.Mask.gbr, radar-F.SilkS.gbr, radar-In1.Cu.gbr]
2018-04-13 Copy BOM generator from https://productize.be/kicad-bom-generation/
2018-04-14 Start work on ADC board
    [digital.kicad_pcb, digital.sch, iCE5LP1KPinout.csv]
2018-04-14 Small fixes; update Gerber
    [radar.kicad_pcb]
2018-04-14 Update Gerber for real
    [radar-B.Cu.gbr, radar-B.Mask.gbr, radar-B.SilkS.gbr, radar-Edge.Cuts.gbr, radar-F.Cu.gbr, radar-F.Mask.gbr, radar-F.SilkS.gbr, radar-In1.Cu.gbr]
2018-04-14 Generate STM32 MCU library file
    [stm32f070.csv]
2018-04-14 Convert high pass from MFB to Sallen-Key; forgot about low input impedance for high pass MFB
    [input.sch, levelshifter.sch, mixer.sch, pa.sch, power.sch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]
2018-04-15 Massage vias to improve planes and swap out connectors to get more ground lines
    [input.sch, levelshifter.sch, mixer.sch, pa.sch, power.sch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]
2018-04-15 Add in STM32, connect up digital part of board
    [adc.sch, ice40.sch, stm32.sch, stm32f070.csv]
2018-04-17 Finish schematic TODO footprints
    [adc.sch, digital.sch, ice40.sch, power.sch, stm32.sch]
2018-04-17 Improve layout slightly
    [radar-B.Cu.gbr, radar-B.Mask.gbr, radar-B.SilkS.gbr, radar-Edge.Cuts.gbr, radar-F.Cu.gbr, radar-F.Mask.gbr, radar-F.SilkS.gbr, radar-In1.Cu.gbr]
2018-04-17 Finish schematic and footprinting of digital board
    [adc.sch, digital.sch, ice40.sch, stm32.sch]
2018-04-17 Fix voltage rails on op amp
    [radar.kicad_pcb, rf2baseband.sch]
2018-04-18 Add gain stage; hopefully ready to start layout now
    [adc.sch, digital.sch, ice40.sch, stm32.sch]
2018-04-18 Line up connectors across both boards, spread out component footprints
    [digital.kicad_pcb, digital.sch, power.sch, radar.kicad_pcb, radar.sch, stm32.sch]
2018-04-18 Finish digital layout
    [adc.sch, digital.kicad_pcb, digital.sch, ice40.sch, stm32.sch]
2018-04-19 Fix up some minor things
    [digital.kicad_pcb]
2018-04-19 Add via stitching to RF board
    [radar-B.Cu.gbr, radar-B.Mask.gbr, radar-B.SilkS.gbr, radar-Edge.Cuts.gbr, radar-F.Cu.gbr, radar-F.Mask.gbr, radar-F.SilkS.gbr, radar-In1.Cu.gbr]
2018-04-19 Regenerate Gerbers
    [digital-B.Cu.gbr, digital-B.SilkS.gbr, digital-Edge.Cuts.gbr, digital-F.Cu.gbr, digital-F.SilkS.gbr, digital-NPTH-drl_map.gbr, digital-NPTH.drl, digital-drl_map.gbr]
2018-04-19 Fix silkscreens and regenerate Gerbers
    [digital-B.Cu.gbr, digital-B.SilkS.gbr, digital-Edge.Cuts.gbr, digital-F.Cu.gbr, digital-F.SilkS.gbr, digital-NPTH-drl_map.gbr, digital-NPTH.drl, digital-drl_map.gbr]
2018-04-24 Fix some more stuff I guess
    [digital-B.Cu.gbr, digital-B.Mask.gbr, digital-B.SilkS.gbr, digital-Edge.Cuts.gbr, digital-F.Cu.gbr, digital-F.Mask.gbr, digital-F.SilkS.gbr, digital-NPTH-drl_map.gbr]
2018-04-27 Test out soft start circuit
2018-04-27 Finish tweaking soft start circuits
